KakeruVon/RVCCC/README.md

# RVCCC - RISC-V Core Controlled CNN accelerator

An **SoC** project on FPGA featuring a **RISC-V CPU** core with a **CNN accelerating module**. Successfully implemented on **Zynq-7020**. The original project structure came from [`RISC-V-Core-with-Integrated-CNN-Accelerator`](https://github.com/dev-the-desai/RISC-V-Core-with-Integrated-CNN-Accelerator) by `dev-the-desai`, and it has been enriched in multiple ways.

This project is developing under a progressive pattern. The first version `v1` connected the CPU and accelerator through a custom CNN trigger instruction. `v2` replaced that custom control path with memory-mapped I/O, added an LED register and a UART peripheral, and let the CPU run a normal RV32I polling program to control CNN inference. The current implementation is `v3`, which uses UART RX to load one MNIST image into data RAM at runtime, runs the CNN accelerator, sends the prediction back through UART TX, and repeats this flow for batch inference and accuracy testing.

The purpose of this project is to accelerate neural network inference with hardware logic. I built a CNN model with 2 convolution+pooling+ReLU layers and 1 fully connected layer, trained with the MNIST dataset, and implemented the model on FPGA to recognize the numbers in MNIST test images.

In early development, I implemented the Verilog code with [`nvboard`](https://github.com/NJU-ProjectN/nvboard), then I moved to an actual Xilinx [Zynq-7020](https://www.en.alinx.com/Product/SoC-development-Boards/Zynq-7000-SoC/AX7020.html) board.

Detailed version notes are maintained separately in [`doc/Versions of the Project.md`](doc/Versions%20of%20the%20Project.md).

## File Structure

The main project files include the infrastructure, the hardware logic, the software stack, generated memory images, and reference notes.

```text
RVCCC/
|-- vsrc/                      # Synthesizable Verilog sources
|   |-- RVCCC.v                # Current top level: CPU, CNN, MMIO, LED, and UART integration
|   |-- riscv_core.v           # Five-stage RV32I CPU modules
|   |-- Instruction_Memory.v   # 1KB instruction RAM loaded from instruction.mem
|   |-- Data_Memory.v          # 4KB byte-lane true dual-port RAM shared by CPU and CNN
|   |-- cnn_core.v             # Sequential fixed-point CNN accelerator
|   |-- Mapped_IO.v            # CNN, LED, and UART memory-mapped register block
|   |-- CLK_Gen.v              # Clock divider for current CPU/CNN clocks
|   |-- uart_top.v             # UART wrapper, 8N1, default 115200 baud
|   |-- uart_tx.v              # UART transmitter
|   |-- uart_rx.v              # UART receiver
|   `-- output.v               # LED and legacy seven-segment display helpers
|-- programs/
|   |-- cnn_mmio_poll.S        # UART image-loading, CNN polling, LED, and UART result program
|   `-- uart_echo.S            # UART RX/TX loopback test
|-- testbench/
|   |-- RVCCC_tb.v             # Integrated CPU + CNN + MMIO + UART testbench
|   `-- RVCCC_rv32i_tb.v       # RV32I datapath self-test testbench
|-- csrc/
|   `-- run.cpp                # Verilator + NVBoard simulation entry
|-- constr/
|   |-- RVCCC.xdc              # Vivado FPGA pin and clock constraints for AX7020/Zynq-7020
|   `-- RVCCC.nxdc             # NVBoard pin mapping
|-- models/
|   |-- __init__.py
|   `-- cnn_model.py           # PyTorch CNN definition used for MNIST training
|-- scripts/
|   |-- train.py               # Train the PyTorch MNIST model
|   |-- quantize.py            # Export fixed-point weights and biases to Verilog .mem files
|   |-- quantize_adaptive.py   # Export fixed/adaptive quantization variants
|   |-- testmem.py             # Select one MNIST test image and generate cnn.mem
|   |-- sim.py                 # Integer CNN simulator matching the Verilog datapath
|   |-- batch_accuracy.py      # Batch accuracy test for floating-point and quantized inference
|   |-- debug_verify.py        # Detailed software/hardware consistency checks
|   |-- asm_to_mem.py          # Build RV32I assembly into instruction.mem
|   `-- uart_test.py           # Host-side UART image sender and batch accuracy helper
|-- mem_files/
|   |-- instruction.mem        # 1KB instruction memory image, one 32-bit word per line in hex
|   |-- data.mem               # First 3KB data-memory byte source
|   |-- data_b*.mem            # First 3KB split into four byte-lane RAM init files
|   |-- cnn.mem                # 1024-byte image file used by software simulation and UART sending
|   |-- test_image.png         # Preview image generated by scripts/testmem.py
|   |-- kernel*.mem            # Quantized convolution kernels and biases
|   |-- weights.mem            # Quantized fully connected weights
|   |-- biases.mem             # Quantized fully connected biases
|   |-- fixed/                 # Fixed-shift quantization output
|   `-- adapt/                 # Per-layer adaptive-shift quantization output
|-- weights/
|   `-- mnist_cnn.pth          # Trained PyTorch model checkpoint
|-- data/
|   `-- MNIST/raw/             # Local MNIST dataset cache used by TorchVision
|-- doc/
|   `-- Versions of the Project.md
|-- Makefile                   # Verilator/NVBoard and RV32I program build flow
|-- LICENSE
`-- LICENSE_original
```

The current hardware entry point is `vsrc/RVCCC.v`. The current software entry points are the Python scripts under `scripts/`, which train the reference model, quantize it, prepare MNIST images, assemble the RV32I control program, run host-side UART tests, and check the fixed-point inference behavior before the generated memory files are used by Verilog or the FPGA board.

## Quick Start

### Python Environment

The software side uses `PyTorch`, `TorchVision`, `NumPy`, `Pillow`, and `pyserial`. A typical local setup is:

```bash
pip install torch torchvision numpy pillow pyserial
```

Train the CNN model:

```bash
python scripts/train.py
```

Export fixed-point parameters for hardware:

```bash
python scripts/quantize.py
```

Generate one MNIST test image for software simulation or UART sending. The optional argument is the MNIST test-set index:

```bash
python scripts/testmem.py 64
```

Run the integer software simulator against the generated `.mem` files:

```bash
python scripts/sim.py --verbose
```

Run a batch accuracy check in software:

```bash
python scripts/batch_accuracy.py --count 1000
```

### Assembly to Instruction Memory

Write the CPU program as RV32I assembly under `programs/`, then assemble it into the 1KB instruction-memory image used by Verilog:

```bash
python scripts/asm_to_mem.py programs/cnn_mmio_poll.S -o mem_files/instruction.mem
```

Or through Make:

```bash
make program ASM=programs/cnn_mmio_poll.S
```

The converter expects a RISC-V GNU bare-metal toolchain in `PATH`, such as `riscv64-unknown-elf-gcc` plus `riscv64-unknown-elf-objcopy`. If the tools use custom names or paths, pass them explicitly:

```bash
python scripts/asm_to_mem.py programs/cnn_mmio_poll.S \
  --cc /path/to/riscv64-unknown-elf-gcc \
  --objcopy /path/to/riscv64-unknown-elf-objcopy
```

The generated `.mem` file contains one 32-bit instruction word per line in hex, padded to 256 words with `00000000`, matching the current `Instruction_Memory` depth.

### UART Board Test

The current v3 board flow receives image bytes over UART instead of relying on a preloaded CNN image region. After programming the FPGA and loading `programs/cnn_mmio_poll.S` into `mem_files/instruction.mem`, send one generated MNIST image and wait for the board prediction:

```bash
python scripts/uart_test.py --image-index 64 --port COM7
```

Send several selected images:

```bash
python scripts/uart_test.py --image-index 64 65 66 --port COM7
```

Run a batch test over MNIST test indices `0..COUNT-1` and print accuracy:

```bash
python scripts/uart_test.py --batch 100 --port COM7
```

When `--port` is omitted, the script tries to choose a likely serial port automatically. Use `--list` to inspect available ports.

### RTL Simulation

For ModelSim-style simulation, compile the Verilog files under `vsrc/` and `testbench/RVCCC_tb.v`, start `RVCCC_tb`, add the desired waveforms, and run until completion. The integrated testbench releases reset, observes the MMIO polling program and CNN inference path, prints the decoded active-low LED prediction, and reports UART transmit bytes.

For the NVBoard/Verilator path, make sure `NVBOARD_HOME` points to a valid NVBoard installation, then run:

```bash
make run
```

The Makefile was originally written for a Unix-like Verilator/NVBoard environment, so path tools such as `find`, `mkdir`, and `rm` are expected in that flow.

### FPGA Build Notes

The Vivado constraint file maps the current top-level ports to the Zynq-7020 board:

| Signal | Meaning | Constraint |
| --- | --- | --- |
| `clk` | External 50 MHz input clock | `U18` |
| `sysrst` | Reset input | `N15` |
| `ledr[3:0]` | Active-low binary prediction output | `M14`, `M15`, `K16`, `J16` |
| `uart_tx` / `uart_rx` | UART output/input | `H15` / `K14` |

The current design connects to a 50 MHz crystal oscillator clock and divides it by two in `CLK_Gen`, so both `clk_cpu` and `clk_cnn` run at 25 MHz with the same phase. This intentionally avoids clock-domain crossing issues while the MMIO-based CPU/CNN control path and UART image-loading path are being validated. Later versions can reintroduce separate CPU and accelerator clocks once the bus and synchronization design are cleaner.

## Current Limitations and Future Work

- The CPU and CNN are integrated, but the CPU does not yet manage a complete SoC-level dataflow with a bus, host protocol, accelerator scheduling, and dynamic program loading.
- Instruction RAM still loads from `.mem`; the current UART flow updates the CNN image at runtime, but the CPU program itself is still prepared offline.
- The data RAM uses four byte-lane `.mem` files for the first 3KB initialization so Vivado can infer true dual-port block RAM. The final 1KB CNN image region is now normally written over UART at runtime.
- The UART protocol is intentionally simple: raw 1024-byte image in, ASCII digit plus CR/LF out. Later versions can add framing, checksums, timeout handling, or commands for model/input management.
- The CNN accelerator is sequential and resource-conscious; later versions can explore more parallelism, DMA-style data movement, and a cleaner SoC bus interface.
- The current visible board output is a 4-bit LED prediction plus UART text output. Earlier seven-segment display logic is kept in comments, and future versions may restore a richer board-level display or host-side reporting protocol.
