KakeruVon/RVCCC/scripts/train.py

import sys
import os
sys.path.append(os.path.dirname(os.path.dirname(os.path.abspath(__file__))))

import torch
import torch.nn as nn
import torch.optim as optim
from torchvision import datasets, transforms
from torch.utils.data import DataLoader
from models.cnn_model import SimpleCNN

# Step 1: Prepare MNIST data and resize each image from 28x28 to 32x32.
transform = transforms.Compose([
    transforms.Resize((32, 32)),
    transforms.ToTensor(),
])

train_dataset = datasets.MNIST(root='./data', train=True, download=True, transform=transform)
test_dataset = datasets.MNIST(root='./data', train=False, download=True, transform=transform)

train_loader = DataLoader(train_dataset, batch_size=64, shuffle=True)
test_loader = DataLoader(test_dataset, batch_size=64, shuffle=False)

# Step 2: Initialize the model, loss function, and optimizer.
device = torch.device("cuda" if torch.cuda.is_available() else "cpu")
model = SimpleCNN().to(device)
criterion = nn.CrossEntropyLoss()
optimizer = optim.Adam(model.parameters(), lr=0.001)

# Step 3: Train the model for a small fixed number of epochs.
epochs = 5
for epoch in range(epochs):
    model.train()
    for images, labels in train_loader:
        images, labels = images.to(device), labels.to(device)
        optimizer.zero_grad()
        outputs = model(images)
        loss = criterion(outputs, labels)
        loss.backward()
        optimizer.step()
    print(f'Epoch [{epoch+1}/{epochs}], Loss: {loss.item():.4f}')

# Step 4: Evaluate classification accuracy on the MNIST test set.
model.eval()
correct = 0
total = 0
with torch.no_grad():
    for images, labels in test_loader:
        images, labels = images.to(device), labels.to(device)
        outputs = model(images)
        _, predicted = torch.max(outputs.data, 1)
        total += labels.size(0)
        correct += (predicted == labels).sum().item()
print(f'Test Accuracy: {100 * correct / total:.2f}%')

# Step 5: Save the trained model parameters for later quantization/export.
torch.save(model.state_dict(), './weights/mnist_cnn.pth')
