KakeruVon/RVCCC/(commit log)

2026-07-25 The first SUCCESSFUL implementation!
    The project is named "RISC-V Core Controlled CNN Accelerator" (RVCCC) and is a RISC-V CPU with an integrated CNN accelerator.
    The project is implemented in Verilog and tested on the Zynq-7020 board.
    Done with multiple changes to reduce resource usage:
    - Use a single MAC for both convolution and fully connected layers.
    - Use a sequential FSM to control the CNN inference process instead of a parallel pipeline.
    - Modified the read logic to adhere block RAM features, avoiding the use of LUTs to implement the memory.
    Successfully tested on the Zynq-7020 board for the first time, the vivado project is at:
    ../Verilog/Xilinx/riscv_cnn_dev
    Longe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
    [batch_accuracy.py, cpu_tb.v, debug_verify.py, quantize.py, quantize_adaptive.py, sim.py]
2026-07-27 v2.03 Full RV32I ISA implementation - Now the CPU supports all the RV32I instructions. - v2.03 is successfully implemented.
    I published this extension at v2.02, but I didn't implement the code since v2.01 and I found problems in the mem struct during synth.
    I had to republish v2.02 to modify mem struct, then I was able to publish v2.03 for the inst update.
    [cpu_rv32i_tb.v]
2026-07-28 v2.04 Trivial modification Deleted the original memory led display, because I will remove the GCD program in the future.
2026-07-28 v2.1 MMIO implementation - Now CPU controls cnn module and led display by MMIO. - CPU uses polling to wait for signals. - Updated the instructions as well as the assembly program. - v2.1 is successfu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
2026-07-29 v2.1.1 Assembly program to mem file - Provided a tool chain to generate instruction.mem from the handwritten assembly program.
2026-08-02 v2.2 UART implementation - Sim successful, not implemented on FPGA yet
2026-08-04 v2.2.1 Developed a temp script to test uart output.
2026-08-04 v2.3 A temp clock config & UART verification - Now clk is connected to U18 pin, which is a 50MHz cristal oscillator. - The clk is divided by 2 to generate 25MHz for both CPU and CNN temorarily. - Suc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
2026-08-04 v2.4 The final update of v2 - File structure reorganized to adapt future expansion of the project. - Successfully implemented on board.
2026-08-05 v3.0.1 Added a UART echo program to test rx functionality. - Successfully tested on board.
2026-08-06 v3.1 A simple try to upload cnn.mem to mem with UART. - Not successful yet.
2026-08-06 v3.2 Batch send and receive data through UART - Successfully implemented on board. - Sometimes it seems to be blocked after reset, that it don't send the result after images sent to it, and the led s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
    [Data_Memory.v, riscv_core.v, testmem.py, uart_test.py]
2026-08-06 v3.3 Batch inference and result accuracy - Successfully tested on board. - Now real batch test is achieved.
2026-08-08 v3.4 The final update of v3 - rearranged README with the current file struct.
